RaghavpravinKS/flyhigh/README.md

# **Flight Controller using Aries Development Board**  

## **Overview**  
This project implements a **PID-based flight controller** on the **Aries V3 development board** to control a quadcopter drone. It processes real-time sensor data from an **MPU6050 IMU** using a **complementary filter** for accurate motion estimation and stabilization. The system communicates wirelessly using an **NRF24L01 module** and utilizes a **3D-printed frame** for a lightweight design.  

## **Features**  
✅ PID-based control for stable flight  
✅ Complementary filter for sensor fusion  
✅ Real-time wireless communication with **NRF24L01**  
✅ Lightweight 3D-printed quadcopter frame  

## **Hardware Components**  
- **Aries V3 Development Board**  
- **MPU6050 IMU Sensor** (Accelerometer + Gyroscope)  
- **NRF24L01 Module** (Wireless communication)  
- **Brushless DC Motors + ESCs**  
- **3D-printed Quadcopter Frame**  
- **LiPo Battery & Power Distribution Board**  

## **Software & Tools**  
- **Arduino IDE** (Code development & uploading)  
- **Embedded C** (Flight control algorithm)  
- **Complementary Filter** (Sensor fusion)  
- **PID Controller** (Stable altitude & attitude control)  

## **Future Improvements**    
- Add **GPS module** for autonomous navigation  
- Optimize **PWM control for smoother flight dynamics**
- Create our owm Motor Speed Controller

## **Contributors**  

| Name | Degree | Institution |  
|---|---|---|
| **Sushant Gudmewar** | Electrical Engineering | IIT Gandhinagar |  
| **Raghavpravin K S** | Electrical Engineering | IIT Gandhinagar |  

---
