RaghavpravinKS/flyhigh/(commit log)

2024-05-23 Added PID functionality
2024-06-19 Added Kalman Filter
2024-06-22 Adjusted motor speeds
2024-06-23 Adjusted motor values
2024-06-23 added median filter
2024-06-24 Added filter for gyro data
2024-06-24 changed filter size
2024-06-24 Changed Lowpass filter freq cutoff
